Jeswin010/cartesian-ironing-robot/robot_setup.jpg

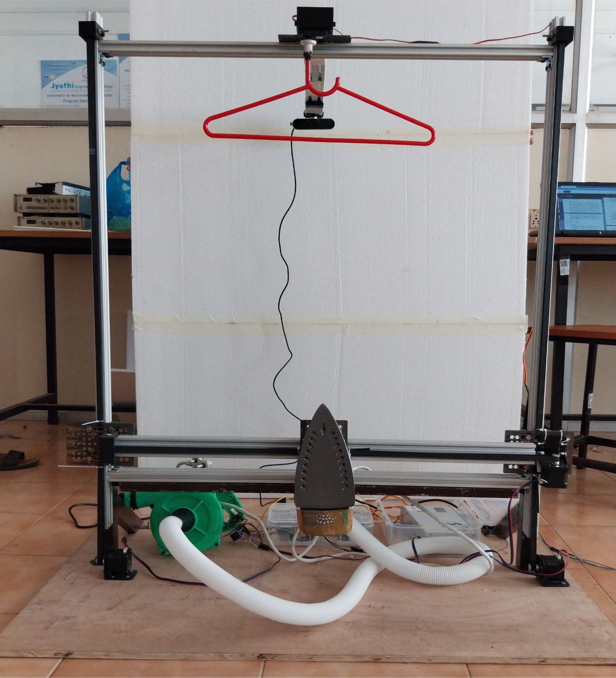
robot_setup.jpg
