Jeswin010/cartesian-ironing-robot/(commit log)

2026-04-05 Update README with demo video description
    The demo video shows an early hardware test. The current codebase reflects the complete pipeline.
2026-04-05 Add Arduino controller sketch
